lyingrushi-oss/STM32F103C8T6_BalanceCar/平衡车3D模型.STL

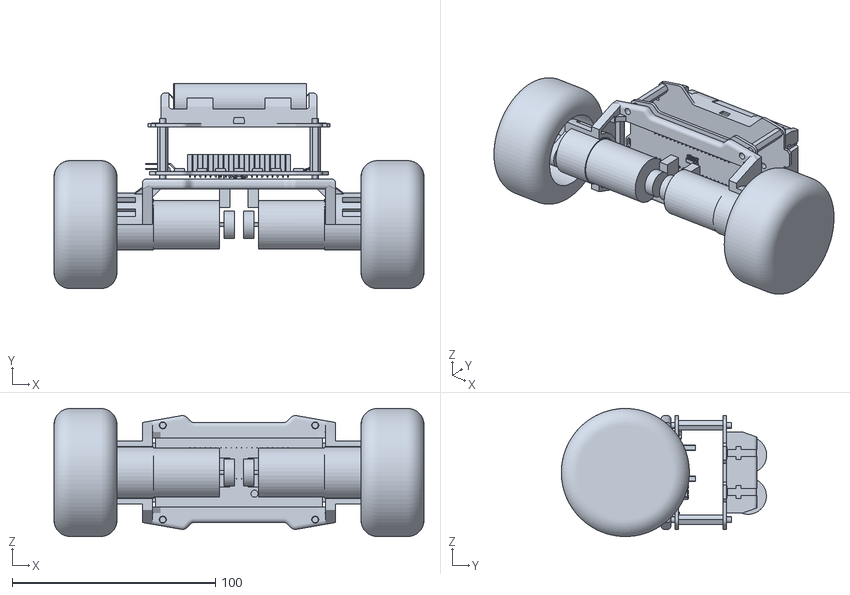
[picture p1: CAD file, 2026-10-13]
平衡车3D模型.STL
182.0 x 101.0 x 63.0
