lyingrushi-oss/STM32F103C8T6_BalanceCar/Balance_Car开发日志.md

# ADC电池电压采集
## ADC信号采集
* ADC参数的配置 
* 电池电压的测量：一节干电池是4.2V,两节串联就是8.4V，而单片机承受的电压范围为0-3.3V，肯定不能把电源正负极直接接在单片机ADC输出引脚上，会烧坏单片机引脚的。所以在外面设计两个电阻，一个3.3k,一个5.1k，进行分压，从而使得输入单片机的最大电压刚好是3.3V。根据ADC中的数据寄存器的值和4095的比值以及分压关系就可以算出电池的电压
## *电源电量指示模块*
通过得到的电池电压的值分成不同的电量，从而三颗指示灯对应不同的状态即可显示点亮。
* LED快闪模式的设计:裸机开发、任务切片，不能使用delay,所以这里使用状态机和轮询扫描模式，设置变量state记录当前LED状态，获取当前时间，当当前时间与lasttime时间间隔>100ms的时候切换LED的状态即可

# 电机调速部分
## *电机等效模型的搭建*
   梦回电机与拖动，看PPT上的等效电路图，主要得到电压、电流与电机转速的关系
## *电机供电来源*
  单片机PWM输出直接供电可以吗？
  - 不行，单片机提供不了那么大的电压，会导致引脚烧毁，所以怎么办呢？
  - 用TB6612电机驱动模块，依然要用stm32的定时器产生PWM信号，不过不是直接给电机供电，而是利用H桥。单片机输出的PWM信号给TB6612的PWM引脚，当pwm引脚输出高电平电机两端电压不为0，当pwm输出低电平时，H桥里面的mos管关断，电机两端电压为0。（用定时器生成的PWM信号控制电机两端的电压大小，将电池电压这个恒定值调制出不同大小的电压信号）
    * 如何控制电机的正反转，通过TB6612的AIN引脚。当AIN1输出高电平，AIN2输出低电平时，电机正转；当AIN1输出低电平，AIN2输出高电平时，电机反转。（其实还是通过TB6612的H桥，4个MOS管）
    * STBY引脚的作用：TB6612的工作状态控制引脚，高电平工作，低电平休眠
## *PWM参数配置*（定时器产生）
  - 分辨率：占空比可调的最小单位，如果是1000级，就代表最小单位是0.1%，在平衡车项目里面我们选择的是1000
  - 周期（频率）：频率越快越好，周期越小越好。这样电机变速比较平滑（输出扭矩和回路电流Ia成正比，而电流Ia有和电机两端电压Ua打大小有关，回路里面有等效的Ra和La,其中电感可以阻碍电流的变化，从而试的电机调速更平滑。频率越高，Ia变化越平滑，就可以近似成直流，这个时候电机调速效果就最好）
  - 占空比：实时计算，根据需要的电压大小计算出对应的占空比 计算公式：Ua=Vbat*duty，导出占空比计算公式 
### 定时器配置
* 模式选择：输出比较产生需要的方波信号（8种输出比较模式，这里选择PWM1模式，当计数器CNT的值<CCR中的值的时候，输出高电平，否则输出低电平）
* 时基单元的配置：见PWM参数配置的分析，想要频率高一点，所以预分频器PSC的值就设置成0。分辨率要1000，使用输出比较功能，所以把自动重装寄存器ARR的值设置成999。至于占空比的配置，只需要把捕获比较寄存器CCR的值设置成需要的值*1000即可
* 输出比较通道的配置：模式选择：PWM1模式，不使用互补输出，选择正极性。CCR的值=duty/100.0f*999(根据duty=CCR/（ARR+1）计算可得到，这里应该是不太重要所以没有加一)

### 电机调速代码
* 函数接口：void App_Motor_Set_L/R(flaot duty)
* 参数：浮点型 duty,其中duty范围为-100.0f-+100.0f,小于零为反转，大于零为正转，通过AIN1/2 BIN1/2引脚电平的输出控制电机的正反转

### 其他要注意的点:
* 左右两个轮子是对称的，如果要往前转，一个是正转，另一个应该是反转，在代码逻辑里面交换一线正反转逻辑就可以了。

## *编码器模块*
使用上面那种算法得到的是电机空载的转速，但是电机要带负载转动，所以要有更准确的测速功能，就要使用编码器测速。电机转动->带动编码器转动
* 编码器模块：有两个传感器，11对磁极，利用霍尔效应，在电机转动的过程中可以产生电势差，根据输出的变化的电压作为脉冲信号就可以测量电机的旋转角度。
* 电机正反转判断：A B两相相差1/4个周期（90°），每转过一个磁极相当于一个周期。当电机正转的时候，A相领先B相1/4个周期。所以在边沿检测的时候，如果捕捉到A的上升沿，这是B相应该是低电平；捕捉到下降沿，B相是高电平。当电机反转，A相捕捉到上升沿，B相是高电平，捕捉到下降沿，B相是低电平.(B领先于A)
### 编码器测速
借助EXTI模块配置GPIO外部中断，检测A相对应的单片机引脚的边沿，从而获取电机转动的线值。（所谓线值，其实就是转过了几个磁极，一个周期是两个磁极。）
* EXTI模块配置
对A相引脚配置EXTI中断，双边沿检测，在每个边沿，对线值进行加减运算。其中，电机正转encoder值++，反转encoder--。（上述运算逻辑写入中断响应函数中，由于encoder为中断和常规程序中都用到的变量，且在中断中被修改，所以记得加*volatile*关键字，防止被编译器优化）
### 平衡车测速
  - 上面得到的是线值，而且是编码器和电机的线值，但是轮胎和电机中间还有一个减速箱。所以要算减速比，在加上减速比以后才是轮胎转动的线值。
  - 减速比的计算：通过数齿轮个数，再根据主动轮和从动轮关系得到减速比是20.4，所以上面算出的encoder再除以20.4就得到轮胎的线值了
  - but，问题又出现了，我们不是想得到角速度吗？我们需要角度啊啊啊。
  由上面的线值和编码器的对应关系，一圈有11对磁极，一个磁极就是一个线值。所以对上面的线值/22.0f* 360.0f,同时把encoder数据类型从整型改成 *float*类型，得到了度数。
自始至终，到现在位置，我们算的是度数，也就是相当于路程吧，还没有得到速度。于是根据度数对时间求导就能得到速度，我们也想用这个方法，但是问题又出现了。我们的encoder是阶梯式增加和减少的，并不是平滑的曲线，这就导致，*求导的结果不是0（阶梯平的地方），就是正无穷或者负无穷（边沿处）*。
于是我们有三种方法测速：1.M法（时间固定，计算固定时间段的encoder变化量）
2.T法 （M固定为1，算出变化1所需要的时间）3.PLL锁相环（但是这个没讲哈哈哈）前两种方法本质上还是利用平均速度代替瞬时速度 
  * *M法*：单片机延时阻塞一段时间后对encoder进行测量，然后根据变化量算出速度（时间间隔选取1ms）
  * *T法*：由于T法选取M固定为1，这样的话没办法表示正反转，所以引入direction变量表示方向，当电机正转，direction=1,反转direction=-1.在这里我们要测量encoder变化1所用的时间，其实也就是要获取边沿出现的时间，所以在中断处理函数里面，在进入中断以后记录当前边沿出现的时间（us级时间），ΔT=t0-t1
  
### ✅T法测速优化
* 问题1 速度不归零
* 问题2 速度换向点异常（速度穿越0的时候波形直上直下，不平滑）
* 问题3 波形有毛刺
#### 速度不归零
* *原因*：由于我们测得的速度永远是上个采样周期的速度，当轮胎不转的时候，就不会触发中断，此时t0 t1的值不会被修改，一直都是停止前的值，所以这个时候算出的速度也会一直是之前的速度，无法回到0
* *解决方法*： 根据*速度不会突变*，所以在每次采样前后的周期所需的时间相差不大。我们选大的时间间隔，本来是 t1<t0<now,现在由于速度已经降到0了，所以我们可以用now-t0作为时间间隔计算，综合就是max(t0-t1,now-t0)
#### 换向点异常
* *原因*： 在速度换向处，drection依然是±1，导致算出来的速度就不可能是0。
* *解决方法*：在中断处理函数中增加对direction变量的处理逻辑。如果当前电机是正转，判断之前电机direction是否为-1，如果为-1说明发生换向，此时给direction赋值为+2（或者也可以直接给0，给±2可以判断换向情况）如果当前电机反转，判断之前direction是否为1，如果为1，则说明发生换向，给direction赋值为+2。然后在返回速度的函数里加处理逻辑判断，如果dierction=+2或者-2直接返回0即可。
#### 出现毛刺怎么办
* *原因*：中断打断测速函数，在获取当前时间now以后触发中断，导致t0和t1的值被篡改。t1<now<t0了，由于这三个变量都是uint64_t类型，所以max((t0-t1),(now-t0))里面（now-t0）会发生溢出，得到一个特别大的数，按照公式除以时间间隔的话，此时的时间间隔是一个很大的数，所以在这一瞬间就会算出速度=0，于是乎，就出现了毛刺。
* *解决方法*： 在获取当前时间now之前关闭中断，复制保存t0,t1的值，然后打开中断，从而就能保证Now始终大于t0的值，从而就不会发生溢出，产生毛刺

# MPU6050解算姿态角
## MPU6050解算姿态角的原理
其实就是MPU6050里面内置了两个传感器，一个陀螺仪，一个加速度计。其中陀螺仪用来获取每个轴上的角速度，加速度计用来获取各个方向上的加速度。
## 陀螺仪和加速度计的区别
* 陀螺仪 (Gyroscope) —— 测量**角速度**
  陀螺仪测量的不是位移，而是旋转的速度（单位通常是 deg/s）。
  它的逻辑： 如果我知道现在车体每秒钟向左倾斜 10°，那么 0.1 秒后，我就能推算出它多倾斜了 1°
  优点： 反应极快，非常灵敏。在平衡车快速倒下的那一瞬间，全靠它捕捉动态。
  缺点： 存在**零点漂移**（*本质上是因为递推算法*）。即使传感器静止，数值也不会完全为 0。通过积分计算角度时，这些微小的误差会随时间累积，导致角度越走越偏（即“漂移”）。
* 加速度计 (Accelerometer) —— 测量**受力情况**
  加速度计测量的是三轴感应到的加速度（单位是 g 或 m/s 2 ）。
  它的逻辑： 在静止或匀速状态下，它唯一受到的力就是地球重力。通过重力在 X、Y、Z 轴上的分量，利用三角函数就能算出当前的绝对倾角。
  优点： 没有累积误差。无论过了多久，它算出的重力方向永远指向地心，能提供稳定的“绝对参考”。
  缺点： 怕震动。平衡车电机转动时会产生巨大的高频震动，加速度计会把这些震动当成加速度信号，导致输出的角度信号**噪音**极大，瞬间跳变。
## 加速度计的建模与理解
其实就是中间有一个小球，被一个正方体包裹，每个面上通过弹簧与小球相连，所以测得的加速度其实是弹簧受力产生的加速度。这也就是为什么说平衡车静止的时候，az不等于0，而是等于g。
**物理模型**：它其实是一个“弹簧秤”
想象加速度计内部有一个小球和几根弹簧。
在太空中静止： 弹簧不动，读数为 0。
在地球上静止： 虽然平衡车整体是静止的，但由于重力的存在，内部的小球会向下拉伸上方的弹簧、压缩下方的弹簧。
传感器的逻辑： 芯片无法分辨“由于重力导致的形变”和“由于向上加速导致的形变”。它只知道：“既然下方的弹簧被压扁了，那一定有一个向上的力在推我。”
所以，当你把 MPU6050 水平静止放在桌面上时，它的 Z 轴会输出 +1g（约 9.8m/s 2）。这个数值代表的是为了抵消重力，桌面对传感器施加的那个向上的支持力。
**弹簧拉伸的方向就是加速度的方向**
*建系是根据小球建的，不是固定的az是数值方向，所以随着小车的移动，坐标系的分布也会发生变化*
## 为什么用了两个传感器
  只用陀螺仪： 车刚开始平衡得很好，但几分钟后，由于漂移，它会认为“垂直位”发生了偏移，最终慢慢倒下。
  只用加速度计： 电机一转，震动传到传感器，数据全是噪声，平衡算法会疯狂抖动，根本站不住。
  互补滤波 (Complementary Filter) 的妙用
  在 STM32 的代码里，我们通常把这两者结合起来：
  短期靠陀螺仪： 用它的灵敏度来应对快速的倾斜变化。
  长期靠加速度计： 用它的稳定性来校准陀螺仪的漂移。
  Angle=0.98×(Angle+Gyro_data×dt)+0.02×(Acc_angle)
  这个公式的意思是：98% 相信陀螺仪的动态表现，2% 相信加速度计的静态修正。

## 解算姿态角
### 陀螺仪解算（递推）
由于陀螺仪测量的是各个方向上的角速度，所以我们可以用上一次的角度θ+Ω*Δt就可以得到角度，但是这样得到的角度经过层层叠加与递推，就会导致误差的积累，所以有漂移问题。
### 加速度计计算（以g为标准）
通过分解重力加速度在各个轴上的分量从而得到对应偏转的角度。由于是以重力加速度为标准，当小车晃动的时候，坐标系也在抖动，就造成此时测得的角度噪声较大。而且，由于重力加速度g和偏航角yaw所在的平面垂直，所以在这个方向上不会有g的分量，因此不能使用这个方法计算yaw偏航角。
### 编程 读写寄存器（8位）
*数据寄存器*：用于存放ax,ay,az,temperature,gx,gy,gz（都各有两个数据寄存器，用于存放高位和低位，记得用高位<<8+地位拼接出结果）注意这里的数据类型记得用有符号int16_t
不管是陀螺仪还是加速度计都要从MPU6050里面获取对应的角速度或者加速度数据，这就需要MPU6050与单片机通信，让单片机获取对应的数据再对数据进行解析和处理。
* *原理*：MPU6050里面有对应的寄存器存储原始数据，此外模块内置**I2C**接口，可以与单片机进行通信（MPU6500:MPU6050的Plus版，还有SPI接口）（还有一种方法是对MPU6050进行编程，因为模块内置了一个微处理器DMP:Digital Motion Processor数字运动处理器 能对数据进行计算。它能直接在传感器芯片内部完成复杂的姿态解算。然后通过接口发给单片机，但是这里我们选用第一种方法总结读取原始数据。）
* *流程*：先对MPU6050进行初始化：（复位模块）->解除睡眠模式 ->配置加速度计和陀螺仪的量程->通信（从机地址+寄存器的地址和值）
  I2C的地址是0xd0(编程的时候不管读写都是这个地址)
拼接好后得到int16_t的原始数据ax,ay,az,temperature,gx,gy,yz(其中，a为加速度计的前缀，g为陀螺仪的前缀)
* 然后使用上面两种方法分别把各个参数对应的计算式列出来，然后对这两种方法进行**互补滤波**处理
* 一般取α=0.98，1-α=0.02，这里我们取的是0.95238
  互补滤波公式的直观拆解$$Angle = \alpha \times (Angle + Gyro \times dt) + (1 - \alpha) \times (Acc\_Angle)$$这个 $\alpha$ 就是互补滤波系数。左半部分（陀螺仪）： 代表“动态”。陀螺仪非常灵敏，能瞬间捕捉到车身的抖动，但时间长了会跑偏。右半部分（加速度计）： 代表“静态”。加速度计全是噪声（电机一转它就乱跳），但它能感知地心引力，长时间看它是准的。
  由于偏航角所在平面与az方向垂直，所以计算yaw过程中只使用陀螺仪计算。
### 解算欧拉角 
根据三角函数关系反解出欧拉角（加速度计）
#### 遇到的问题处理
* 1.俯仰角pitch和翻滚角roll的范围是（-180，180），但是运用反正切arctan能解出的角度范围是（-90，90），这样会导致角度的缺失.
 [解决方案]：使用<math.h>里面的arctan2(y,x)即可
* 2.单片机处理浮点数和三角函数都很慢，会导致平衡车不能及时得到角度数据
  [解决方案]：使用快速三角函数，铁头山羊老师给的“qmath.h”
  原理：查表法，感觉有点像数字信号那种离散信号，设置一个有1000个元素的数组，将sin正弦函数从0到90°中间选1000个点，序号代表点的顺序，不同的点直指向此时的索引对应的sin值。其他范围的值和cos函数直接使用诱导公式化为sin即可，arc=sin/cos
### 进程函数设计
**每5ms更新一次欧拉角的数据**
在这里使用的是period(5)的宏，判断now<nxt,小于就直接返回，大于就执行处理代码。
osDelayUntil(&last, 5) — 就像 nxt += 5 (绝对延迟)
逻辑：它不管你任务跑了多久，它只关心“距离上一次唤醒时间”是否过了 5ms。
优势：自动补偿：如果任务执行花了 1ms，它就只延时 4ms；如果任务花了 2ms，它就只延时 3ms。
无累积误差：长期运行下，总的执行次数是极其精确的。
平衡车意义：这保证了你的姿态解算（积分）和速度控制（微分）拥有一个恒定的时间基准
### 要注意的问题
1.注意单位和量程的问题
* 在配置寄存器的时候，我们选择了陀螺仪和加速度计的范围。陀螺仪的量程为：±2000°/s,加速度计的量程为：±2g。
  所以在拼接好数据以后，还要计算出有意义的数据，这里数据寄存器里的值就有点像ADC的DR一样，要按比例和权重计算出有意义的物理量，raw/32768*2000（单位是°/s），其中raw为原始数据。int16_t 数据类型的表示范围为：-32767-+32768，raw/6.1035e-2。同理加速度计的原始数据也要进行换算，a_raw/32768 *2(单位是g重力加速度) 计算出来是6.1035e-5
2.加速度计解算出来的角度单位是rad,所以还要转换成度数/3.1415927f*360.0f

# 控制系统和PID
## 控制系统简介
*控制系统的组成：设定值SP,控制器，执行器，被控对象，传感器*（一般执行器会和被控对象在一起）
*控制系统的重要指标*：稳准快 调节时间（稳定到5%误差带所需要的时间）、超调量、稳态误差
1. 快 —— 响应速度（调节时间 $t_s$）
  定义： 系统受到扰动后，恢复到平衡状态的速度。
  平衡车表现： 当你用手推一下车，它能多快恢复直立。
  对应 PID： 主要靠 $P$（比例）。$P$ 越大，动力响应越猛，车回正越快。
2. 准 —— 静态精度（稳态误差 $e_{ss}$）
   定义： 系统稳定后，输出值与期望值（目标值）之间的差。
   平衡车表现： 车在稳定站立时，是否一直斜着一个微小的角度（比如始终前倾 $2^\circ$），或者马达是否始终在嗡嗡响却回不到中位。
   对应 PID： 靠 $I$（积分）。积分项会自动累积这些微小的偏差，最终通过加大输出把误差消除。
3. 稳 —— 稳定性（超调量 $M_p$ 与震荡）
   定义： 系统在趋近目标的过程中，是否会冲过头，以及震荡是否能衰减。
    平衡车表现： 车在回正时，是“啪”的一下稳稳停住，还是左右来回晃荡好几下才停。
    对应 PID： 靠 $D$（微分）。微分具有“预测”作用，相当于阻尼器。当它感知到车快要回到中位时，会提前给一个反向的作用力，防止“超调”。
| 指标 | 物理含义 | 关键参数 | 调节策略 |
| :--- | :--- | :---: | :--- |
| **稳 (Stable)** | 不震荡、低超调 | **D** | 加大 D (增加阻尼)，减小 P |
| **准 (Accurate)** | 无静差 | **I** | 加大 I (消除残留误差) |
| **快 (Fast)** | 响应迅速 | **P** | 加大 P (提高力量)，减小 D |

## 电机的建模分析
*电机：将电能转换为机械能*
### 电机的电学和机械建模
* 电学建模：梦回电机与拖动，画等效电路，列KVL。电路包含，电机，电阻Ra,电感La(很多硅钢片叠在一起)，产生的反电动势。
* 机械建模：大学物理 刚体的运动，因为电机的转动惯量是已知的，计算轮胎的转动惯量（积分，微元法），到时候把转动惯量相加即可。列刚体的转动方程。

## 电机参数的测量
### 一般处理方法
① 电阻 R 和 电感 L（电路方程）
现实情况： 电感 L 通常极小，在低频的平衡车控制里几乎可以忽略不计。

做法： 你只需要用万用表测一下电机的端电阻。记得多测几组取平均值，或者转动一下转子再测，因为电刷接触电阻会变。

② 反电动势常数 Ke
物理意义： 电机转得越快，产生的反向电压就越大，会抵消你的输入电压。

简化思路： 如果你没有示波器去测波形，你可以根据电机的额定转速和额定电压倒推。

Ke≈ 额定电压/额定角速度
这是一个非常有效的工程近似值。

③ 转矩常数 Kt
好消息： 在国际单位制（SI）下，对于永磁直流电机，Kt=Ke。（能量守恒/功率可以推出来）
### 在这个项目里的处理
现在可以为您总结直流电机（如JGA25-370）参数的测量方法了。建立电机的完整动力学模型需要测量三大类参数：电气参数、电磁常数和机械参数。具体测量步骤和原理如下：

**1. 电气参数测量（电枢电阻 $R$ 和 电枢电感 $L$）**
*   **测量工具：** 带有夹具的LCR数字电桥测试仪（如Victor 4080 或 Hikari HX-120）。
*   **电感测量：** 将LCR测试仪的频率设置在 **1kHz** 进行测量，直接读取电感值 $L$。
*   **电阻测量：** 将LCR测试仪的频率设置在 **100Hz** 进行测量，读取电枢的直流电阻值 $R$。

**2. 电磁常数测量（反电动势常数 $K_e$ 和 转矩常数 $K_t$）**
*   **反电动势常数 $K_e$：** 根据公式 $e = K_e \cdot \omega$ 计算。可以将两台同型号电机对接耦合，一台通过驱动器（如L298N）控制转动作为动力源，另一台电机开路作为发电机使用。通过单片机测量从动电机的转速 $\omega$（rad/s），并用万用表测量其开路电枢电压（即反电动势 $e$），即可求出 $K_e$。
*   **转矩常数 $K_t$：** 基于能量守恒定律，理想情况下转矩常数与反电动势常数在数值上近似相等，即 $K_t \approx K_e$。也可以通过让电机在最大占空比下运行，测量输入电压 $V_a$、电流 $I_a$ 和转速 $\omega$，计算出总功率扣除铜损（$I_a^2 R$）后的机械功率 $P_m$，再利用公式 $K_t = \frac{P_m}{\omega \cdot I_a}$ 求得。

**3. 机械参数测量（摩擦系数 $B$ 和 负载转矩 $T_L$）**
利用电机匀速转动时处于受力稳态（加速度为0）的特性，即电磁转矩 $T_m = B\omega + T_L$（或写为 $K_t \cdot I_a = B\omega + T_L$）来进行测量。
*   **测量步骤：** 让电机在**两个不同的恒定转速**（稳态点）下运行，分别记录下两组测试数据：转速 $\omega_1, \omega_2$ 以及对应的电枢电流 $I_{a1}, I_{a2}$ 或电磁转矩 $T_{m1}, T_{m2}$。
*   **参数计算：** 
    *   摩擦系数 $B = \frac{T_{m2} - T_{m1}}{\omega_2 - \omega_1}$。
    *   负载转矩 $T_L = \frac{\omega_2 T_{m1} - \omega_1 T_{m2}}{\omega_2 - \omega_1}$ （或将求得的 $B$ 代入稳态方程求出 $T_L$）。

**4. 转动惯量测量（$J$）**
转动惯量的测量需要通过分析电机的**自由减速曲线**来实现。
*   **数据采集：** 将电机加速到某一个稳态转速后，突然断开电枢电路（此时电磁转矩 $T_m = 0$）。利用编码器和单片机（如利用外部中断配合定时器）以较高的采样率（如100Hz）记录电机直到停止过程中的速度随时间变化的离散点数据 $\omega(t)$。
*   **数学建模与拟合：** 此时系统遵循一阶非齐次微分方程 $J\frac{d\omega}{dt} + B\omega = -T_L$，其转速响应曲线包含指数衰减项 $e^{-\frac{B}{J}t}$。
*   **参数计算：** 提取减速曲线中的线性响应部分，将数据导入MATLAB等软件中，通过添加电压偏移进行 **指数回归拟合**。拟合函数形式为 $f(t) = a \cdot e^{-bt}$。根据拟合求出的指数系数 $b = B/J$，结合上一步求得的摩擦系数 $B$，即可最终计算出转动惯量 $J = B/b$。
  
## 波特图
### 波特图的绘制*G（s）尾一标准型*
* 起始：判断系统的型别，v型系统对应起始斜率是-20v;起始的直线过（1，20logK)点
* 零极点：遇到零点斜率+20，极点-20
* 微分/积分：微分的拉普拉斯变换是✖s,所以斜率是+20；积分的拉普拉斯变换是÷s,所以斜率对应-20
### 理想系统的波特图
**PID本质**：PID就是一个校正器，用于系统的闭环控制，通过在原本的系统串联一个PID控制器（在波特图上叠加一条PID控制的线）从而能使系统更稳定
*三段论分析波特图:*
- 低频段：低频陡且高
- 中频段：1.以-20dB/dec穿越横轴；2.范围尽可能宽（此时超调量会比较小）；3.与横轴交点ωc要尽可能大（振荡频率大，调节时间tss就会小，系统稳定性更好）
- 高频段：高频尽量低（因为噪声是高频的，所以要对高频信号进行抑制，纵轴是20logK,放大倍数当然是越小越好，这样系统的抗噪声能力就会好）

## PID编程
### TypeDef定义结构体类型
定义结构体成员 $K_p$ $K_i$ $K_d$ SP（set point 设定值）t_k_1(上一次运行PID的时间) err_k_1(上一次的误差) int_k_1(上一次的积分值))
### 微分和积分的计算
* CO_dev=err[k]-err[k-1]/deltaT *对误差error的微分就是那一点的斜率*
* CO_int=int_k_1+(err[k]+err[k-1])*deltaT/2.0f *上一次的积分值+这一次的小梯形的面积*
  
## PID改进
### 1.PID复位
在平衡车上有一个user_key按钮，用于控制电机的启停，所以在按下这个按键的时候要增加对PID复位的处理，防止原先结构体中残留的数据对下一次开启造成影响（上次运行PID的时间、上一次的误差err、上一次的积分值，对这三个数据进行清零即可）

### 2.CO限幅
输出的$U_a$的范围不能无限大，负责没有意义，在PID_TypeDef结构体里面声明输出上下限（-8.4，+8.4），设置超出限制的逻辑处理代码，超出上限按上限计算，超出下限强制输出下限
### 3.积分限幅
积分是累加递推的结果，很容易跑飞，所以要对积分输出进行限制，防止积分输出溢出，也防止在最后的输出中导致比例环节无效
### 4.忽略第一次的积分环节和微分环节的输出 $CO_{int}$ 和$CO_{dev}$
积分和微分的运算要以来上一次的数据，在第一次运行时没有之前的数据算不出微分和积分环节的输出，所以在初次运算的时候忽略积分环节和微分环节的输出，只保留比例环节（关于怎么判断是不是第一次运行PID，看$t_{k-1}$是否为0即可。）

# 倒立摆
## *倒立摆的作用*
用加速度去控制倾角，通过产生加速度维持平衡
维持平衡车的平衡:往哪个方向倒就往哪个方向加速

# 速度环
## 功能
调节平衡车的水平速度
## 速度环悖论
*速度环里面有倒立摆，也就是直立环*
**如果想要减速**
想要改变速度，所以要用速度环，速度环控制小车向后加速，由于小车向后加速，导致车身向前倒，产生了向前的倾角，这个时候直立环开始校正了，你有向前的倾角，我就向前加速，这个时候向前的速度反而增大了，返回的error增大了。但是我们最开始想要的不是加速吗？？这就是**速度环悖论**
*分析这部分逻辑的时候，记得按顺序分析，你要改变速度，就从速度环开始分析，不要先考虑直立环，不然会被卡死的*
### 解决方法
**忽略掉由于扶正车身产生的角速度和位移，从而让速度环只关速度，直立环只关心平衡**
把平衡车的角速度（编码器测到的速度值）拆解成两个，$ω_1$和$ω_2$,一个向前，一个向后，一个用于平衡，一个用于加速或者减速
把速度环掌控的$ω_1$作为反馈信号，去和设定值SP比较。其实编码器测到的速度转换成线速度以后就是平衡车的平动速度，但是在这里为了解决速度环悖论，我们就牺牲了由于维持平衡产生的角速度和位移。

# 遥控器
## 基本原理概括
使用蓝牙和串口，单片机通过蓝牙模块和手机通信，手机发送指令，单片机接收。指令再通过电脑串口调试助手显示。单片机接收到指令以后对数据进行解析即可
## 数据流向
手机--->蓝牙模块（通信方式：蓝牙）--->STM32(通信方式：串口USART3)--->电脑（通信方式：串口USART2 串口调试助手）
## 数据接收与解析
### 数据接收
在每一条指令（指令里面一个字符就是一个字节）后加'\n'作为指令结束符，通过借助USART接收中断（RXNE接收寄存器非空）对数据进行读取。
建立三个缓冲区，一个用于中断，一个用于中转，一个用于进程函数。
新增一个标志位，代表指令读取和转运结束，进程函数用于不断读取这个标志位
当RXNE中断发生的时候，在相应的IRQHandler函数里面对指令进行读取，读取过程中，没遇到结束标志的时候就把接收的这个字节写入intbuf里面，等到读取到指令结束标志'\n'的时候在intbuf里面写'\0',并把接收完整的一条指令复制到transbuf里面（使用strcpy函数即可实现，完成转运以后就可以把数据发给进程函数啦，进程函数用于对指令进行解析）
### 数据解析
进程函数对标志位进行读取，如果标志位为1，就把中转数组里面的值复制过来处理，判断是不是mov指令（使用strncasecpm判断是不是move指令，是的话就处理，str是字符串，n是比较前n位字符，case是不区分大小写，cmp是比较，一样的话就返回0）
```c
// 判断是不是 mov 指令（使用 strncasecmp 判断是不是 move 指令，是的话就处理）
// 字符串，n 是比较前 n 位字符，case 是不区分大小写，cmp 是比较，一样的话就返回 0

//**sscanf 接口**：用于读取格式化字符串里面的数据

if (sscanf(cmdLine, "move %d %d", &turnspeed, &movespeed) == 2) {
    // 处理逻辑...
    //规定指令里面前后左右的最大速度均为±100，在数据处理过程中对指令里面的速度数据进行解析映射，根据最大速度100比较算出真实的速度
}
```

行内分数：$\frac{234}{456}$
行外分数：$$\frac{234}{456}$$
代码块表示
```cpp
{
 //三对反引号里面就是代码块 
 //第一行反引号后面是语言类型，比如说c/cpp

}
```
