lyingrushi-oss/STM32F103C8T6_BalanceCar/user/app_mpu6050.h

#ifndef APP_MPU6050_H
#define APP_MPU6050_H
#include "stm32f10x.h"
void App_MPU6050_Init(void);
void App_MPU6050_Update(void);

void App_MPU6050_Proc(void);

float APP_MPU6050_GetAx(void);
float APP_MPU6050_GetAy(void);
float APP_MPU6050_GetAz(void);
float APP_MPU6050_GetGx(void);
float APP_MPU6050_GetGy(void);
float APP_MPU6050_GetGz(void);
float APP_MPU6050_GetTemperature(void);
float App_MPU6050_GetYaw(void);
float App_MPU6050_GetPitch(void);
float App_MPU6050_GetRoll(void);
#endif
