lyingrushi-oss/STM32F103C8T6_BalanceCar/user/app_usart2.c

#include "app_usart2.h"

//
//@简介：对串口2进行初始化，作为平衡车的调试接口
//
void App_USART2_Init(void)
{
  //#1.初始化IO引脚 
	//PA2-Tx AF_PP 
	RCC_APB2PeriphClockCmd(RCC_APB2Periph_GPIOA,ENABLE);
	GPIO_InitTypeDef GPIO_InitStruct={0};
	GPIO_InitStruct.GPIO_Pin=GPIO_Pin_2;
	GPIO_InitStruct.GPIO_Mode=GPIO_Mode_AF_PP;
	GPIO_InitStruct.GPIO_Speed=GPIO_Speed_2MHz;
	GPIO_Init(GPIOA,&GPIO_InitStruct);
	//PA3-Rx IPU
	GPIO_InitStruct.GPIO_Pin=GPIO_Pin_3;
	GPIO_InitStruct.GPIO_Mode=GPIO_Mode_IPU;
	GPIO_Init(GPIOA,&GPIO_InitStruct);
	//#2.初始化USART2本身
	RCC_APB1PeriphClockCmd(RCC_APB1Periph_USART2,ENABLE);
	USART_InitTypeDef USART_InitStruct;
	USART_InitStruct.USART_HardwareFlowControl=USART_HardwareFlowControl_None;
	USART_InitStruct.USART_BaudRate=921600;
	USART_InitStruct.USART_WordLength=USART_WordLength_8b;
	USART_InitStruct.USART_StopBits=USART_StopBits_1;
	USART_InitStruct.USART_Parity=USART_Parity_No;
	USART_InitStruct.USART_Mode=USART_Mode_Tx|USART_Mode_Rx;
	USART_Init(USART2,&USART_InitStruct);
	//#3.闭合总开关
	USART_Cmd(USART2,ENABLE);
	
	

}
